Rehabilitation-Innovation/AT-HUB-Recharged/Hardware/Rev3/fa336b_9103eb10317041b39736748acd1199ef~mv2.png

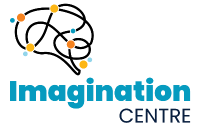
Hardware/Rev3/fa336b_9103eb10317041b39736748acd1199ef~mv2.png
