Rehabilitation-Innovation/AT-HUB-Recharged/Hardware/Rev3/images.png

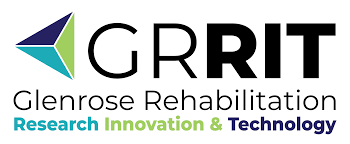
Hardware/Rev3/images.png
