Rehabilitation-Innovation/AT-HUB-Recharged/Hardware/Mechanical Assembly/Full Assembly - AT Hub/Button Cap - AT Hub V1.SLDPRT

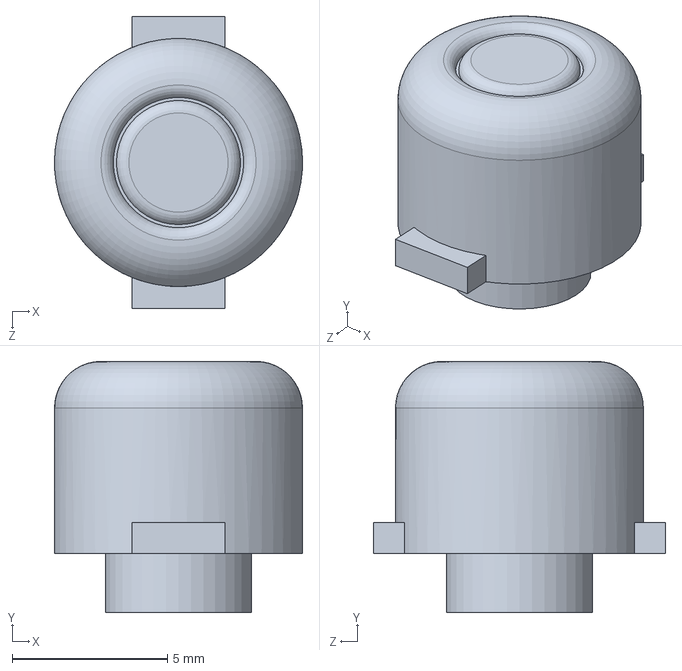
[picture p3: CAD file, 2025-08-19]
Hardware/Mechanical Assembly/Full Assembly - AT Hub/Button Cap - AT Hub V1.SLDPRT
8.00 x 8.10 x 9.42 mm
