Rehabilitation-Innovation/AT-HUB-Recharged/Hardware/Mechanical Assembly/Full Assembly - AT Hub/Switch Cap - AT Hub.SLDPRT

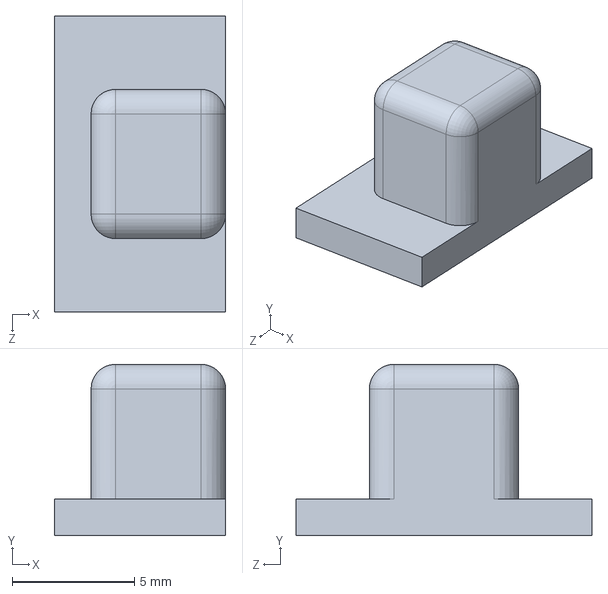
[picture p4: CAD file, 2025-08-19]
Hardware/Mechanical Assembly/Full Assembly - AT Hub/Switch Cap - AT Hub.SLDPRT
7.00 x 7.00 x 12.1 mm
