Rehabilitation-Innovation/AT-HUB-Recharged/Hardware/Rev3/3d/Same_Sky_SLW-864574-5A-RA-N-D.step

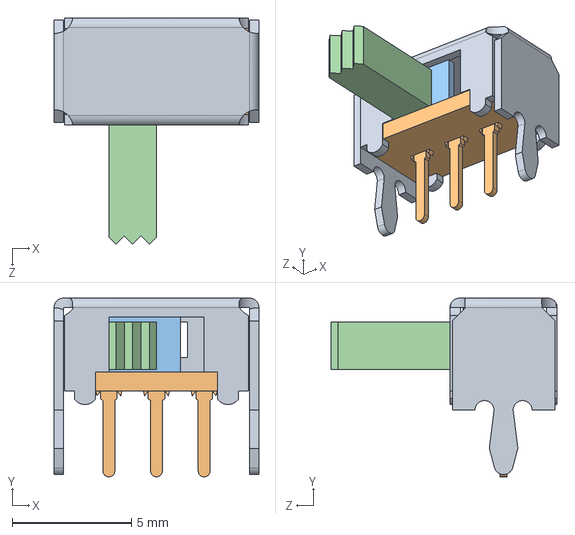
[picture p5: CAD file, 2025-06-05]
Hardware/Rev3/3d/Same_Sky_SLW-864574-5A-RA-N-D.step
8.60 x 7.50 x 9.50 mm
