Rehabilitation-Innovation/AT-HUB-Recharged/Hardware/Rev3/3d/MJ-3502.step

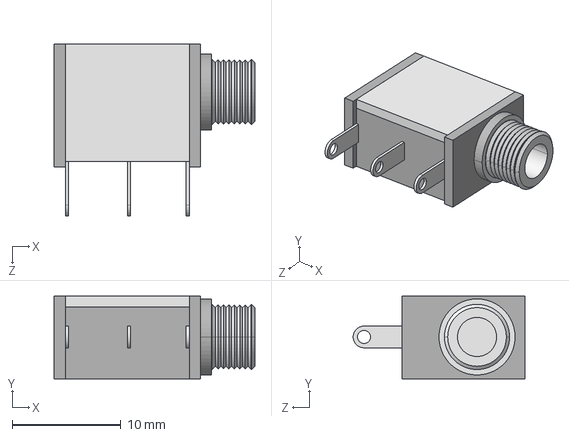
[picture p6: CAD file, 2025-06-05]
Hardware/Rev3/3d/MJ-3502.step
18.5 x 7.60 x 15.8 mm
