Rehabilitation-Innovation/AT-HUB-Recharged/Hardware/Mechanical Assembly/Full Assembly - AT Hub/Base - AT Hub.SLDPRT

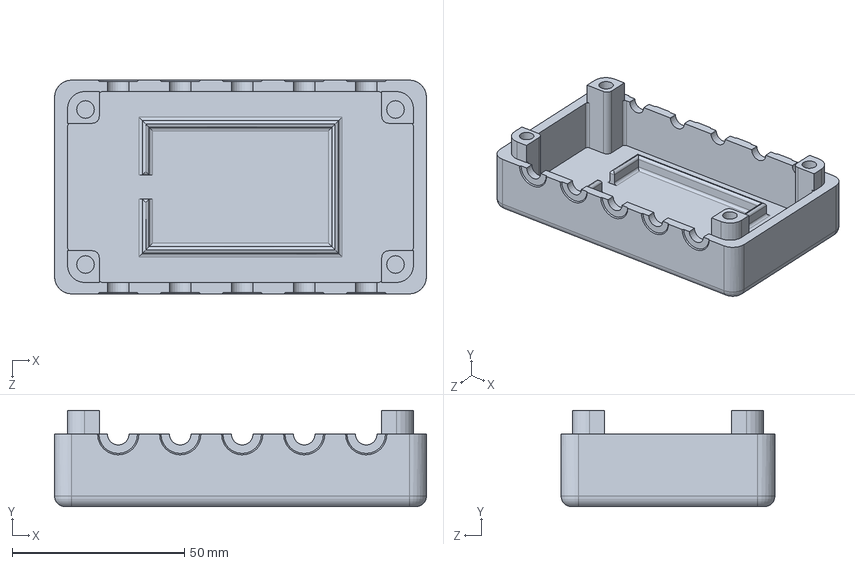
[picture p7: CAD file, 2025-08-19]
Hardware/Mechanical Assembly/Full Assembly - AT Hub/Base - AT Hub.SLDPRT
108.0 x 27.9 x 62.1 mm
