Rehabilitation-Innovation/AT-HUB-Recharged/Hardware/Rev3/3d/800AWSP9M2QE.STEP

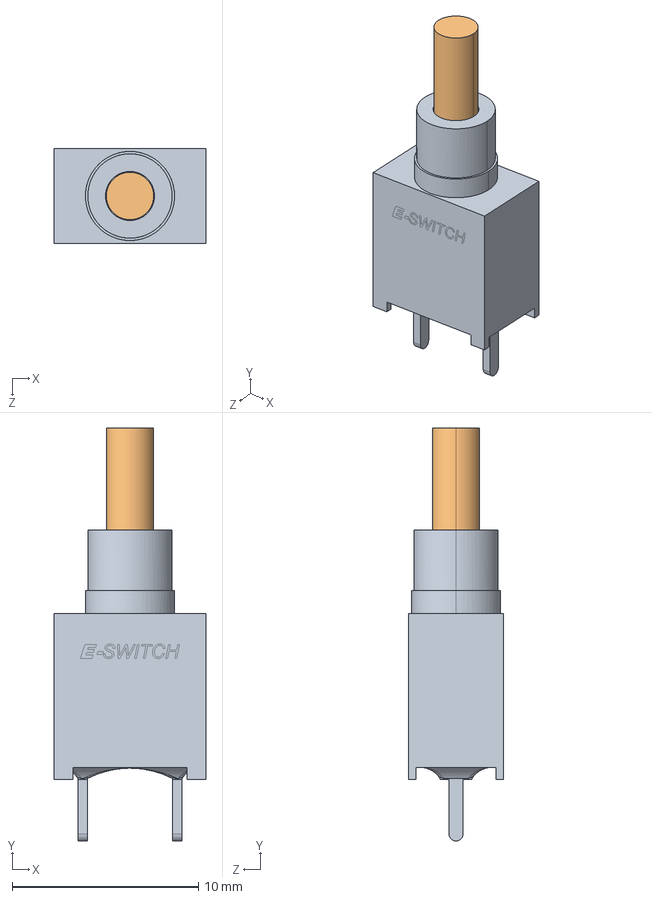
[picture p8: CAD file, 2025-06-05]
Hardware/Rev3/3d/800AWSP9M2QE.STEP
8.13 x 22.2 x 5.08 mm
