Rehabilitation-Innovation/AT-HUB-Recharged/Hardware/Mechanical Assembly/Full Assembly - AT Hub/Top - AT Hub.SLDPRT

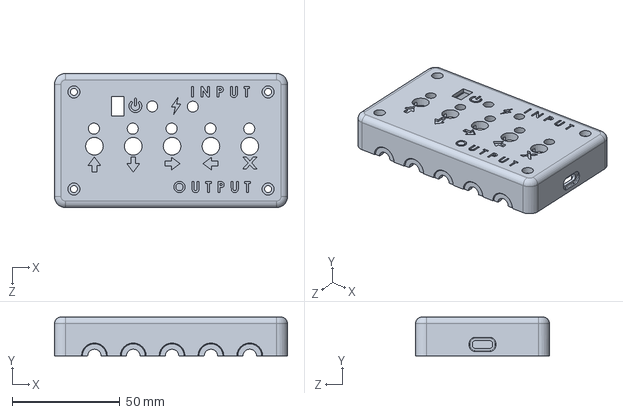
[picture p9: CAD file, 2025-08-19]
Hardware/Mechanical Assembly/Full Assembly - AT Hub/Top - AT Hub.SLDPRT
108.0 x 18.0 x 62.1 mm
