Rehabilitation-Innovation/AT-HUB-Recharged/Hardware/Rev3/3d/MIC2288YD5-TR.STEP

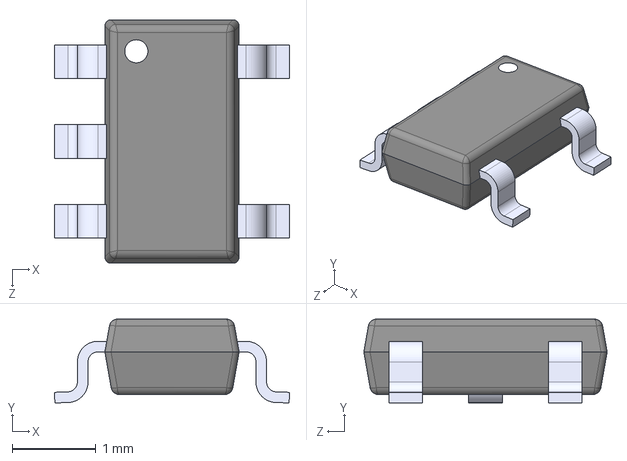
[picture p10: CAD file, 2025-06-05]
Hardware/Rev3/3d/MIC2288YD5-TR.STEP
2.80 x 1.00 x 2.90 mm
