Rehabilitation-Innovation/AT-HUB-Recharged/Hardware/Mechanical Assembly/Full Assembly - AT Hub/AT_HUB_RECHARGED 4.step

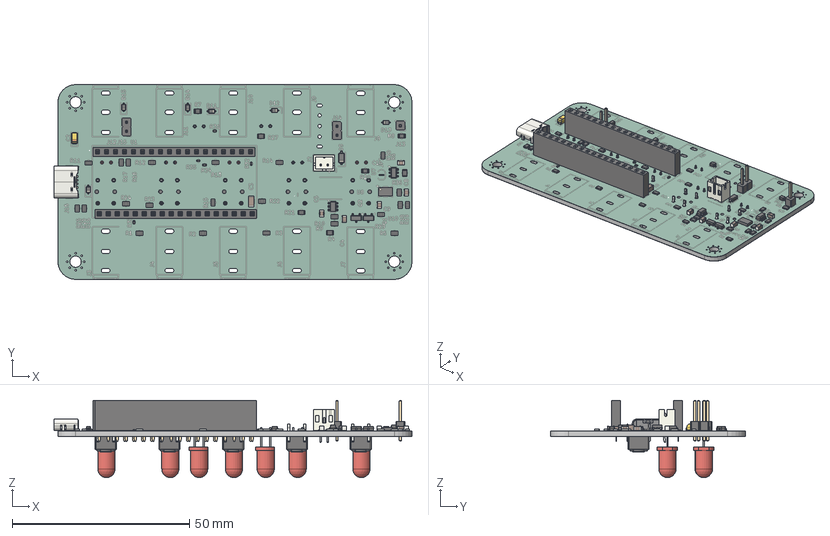
[picture p11: CAD file, 2025-07-30]
Hardware/Mechanical Assembly/Full Assembly - AT Hub/AT_HUB_RECHARGED 4.step
101.1 x 55.0 x 21.8 mm
C_0805_2012Metric x 5
PinHeader_1x02_P2.54mm_Vertical x 2
R_0805_2012Metric x 30
D_SOD-123
SOT-23-6 x 2
D_SOD-323 x 6
SOT-23 x 2
JST_PH_B2B-PH-K_1x02_P2.00mm_Vertical
R_0402_1005Metric x 5
PinHeader_1x01_P2.54mm_Vertical
PinSocket_1x18_P2.54mm_Vertical x 2
Texas_S-PDSO-N12
USB_C_Receptacle_GCT_USB4125-xx-x_6P_TopMnt_Horizontal
C_1206_3216Metric
CP_EIA-3216-18_Kemet-A
LED_D5.0mm x 7
SW_PUSH_6mm x 5
AT_HUB_RECHARGED_silkscreen
AT_HUB_RECHARGED_soldermask
AT_HUB_RECHARGED_PCB
