Rehabilitation-Innovation/AT-HUB-Recharged/Hardware/Rev3/3d/NRS6028T4R7MMGKV.STEP

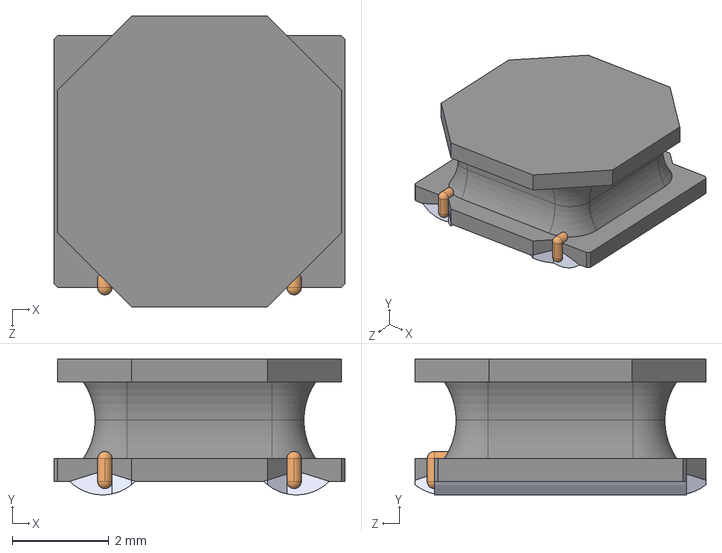
[picture p12: CAD file, 2025-06-05]
Hardware/Rev3/3d/NRS6028T4R7MMGKV.STEP
6.00 x 2.80 x 6.00 mm
