Rehabilitation-Innovation/AT-HUB-Recharged/Hardware/Rev3/3d/TLP241A_TP1_F.step

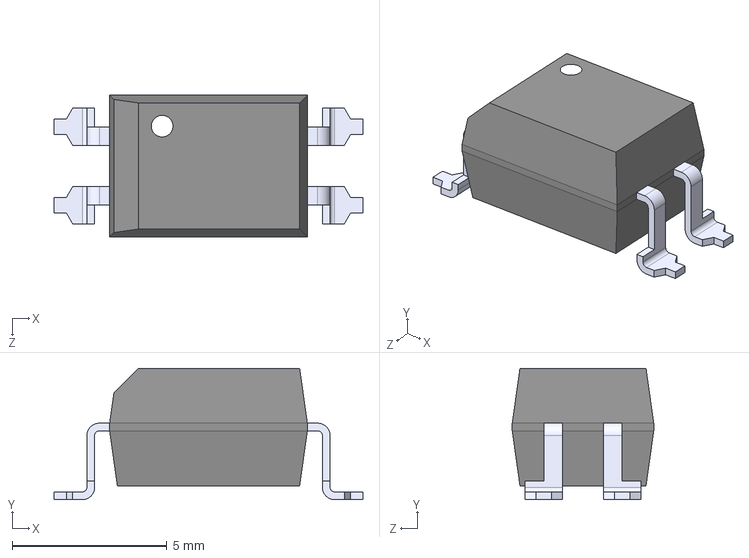
[picture p13: CAD file, 2025-03-25]
Hardware/Rev3/3d/TLP241A_TP1_F.step
10.0 x 4.25 x 4.58 mm
