Rehabilitation-Innovation/AT-HUB-Recharged/Hardware/Rev3/3d/MAX17048G_T10.step

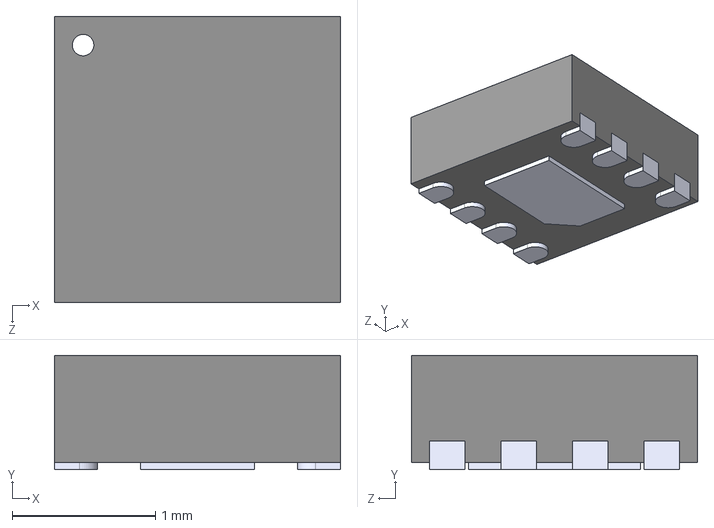
[picture p14: CAD file, 2025-06-27]
Hardware/Rev3/3d/MAX17048G_T10.step
2.00 x 0.8 x 2.00 mm
