Rehabilitation-Innovation/AT-HUB-Recharged/Hardware/Rev3/3d/BQ27427YZFR.step

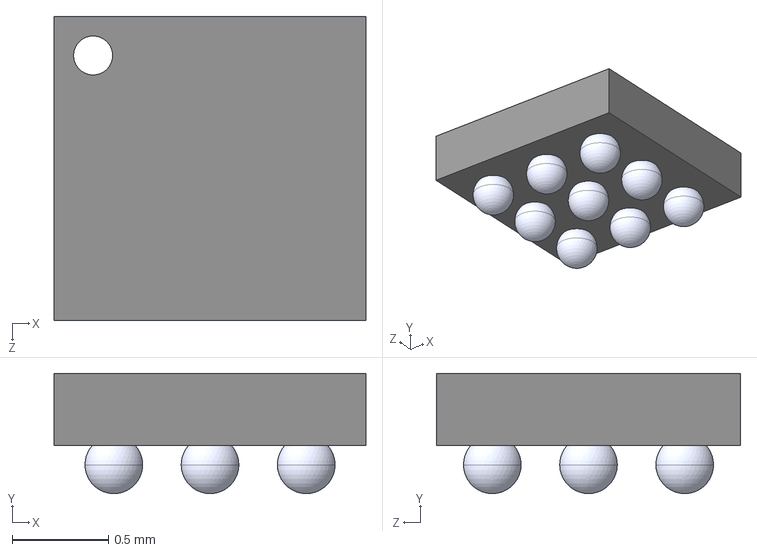
[picture p15: CAD file, 2025-06-05]
Hardware/Rev3/3d/BQ27427YZFR.step
1.62 x 0.625 x 1.58 mm
