Rehabilitation-Innovation/AT-HUB-Recharged/Hardware/Mechanical Assembly/Full Assembly - AT Hub/Full Assembly - AT Hub.SLDASM

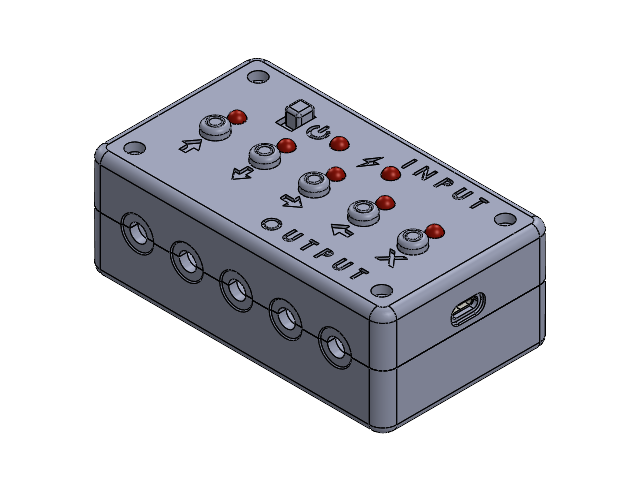
[picture p16: CAD file, 2025-08-19]
Hardware/Mechanical Assembly/Full Assembly - AT Hub/Full Assembly - AT Hub.SLDASM
Base - AT Hub
Top - AT Hub
Button Cap - AT Hub V1 x 5
C_0805_2012Metric.step x 5
PinHeader_1x02_P2.54mm_Vertical.step x 2
R_0805_2012Metric.step x 30
D_SOD-123.step
SOT-23-6.step x 2
D_SOD-323.step x 6
SOT-23.step x 2
JST_PH_B2B-PH-K_1x02_P2.00mm_Vertical.step
R_0402_1005Metric.step x 5
PinHeader_1x01_P2.54mm_Vertical.step
PinSocket_1x18_P2.54mm_Vertical.step x 2
Texas_S-PDSO-N12.step
USB_C_Receptacle_GCT_USB4125-xx-x_6P_TopMnt_Horizontal.step
C_1206_3216Metric.step
CP_EIA-3216-18_Kemet-A.step
LED_D5.0mm.step x 7
SW_PUSH_6mm.step x 5
AT_HUB_RECHARGED_silkscreen.step
AT_HUB_RECHARGED_soldermask.step
AT_HUB_RECHARGED_PCB.step
Switch Cap - AT Hub
