Rehabilitation-Innovation/AT-HUB-Recharged/(list of files, cad)

Other CAD files:
Hardware/Mechanical Assembly/Full Assembly - AT Hub/AT_HUB_RECHARGED 4.SLDASM
