Rehabilitation-Innovation/AT-HUB-Recharged/Hardware/Rev3/AT_HUB_RECHARGED/AT_HUB_RECHARGED.kicad_pcb

## KiCad design Hardware/Rev3/AT_HUB_RECHARGED/AT_HUB_RECHARGED.kicad_pcb (2025-08-11)

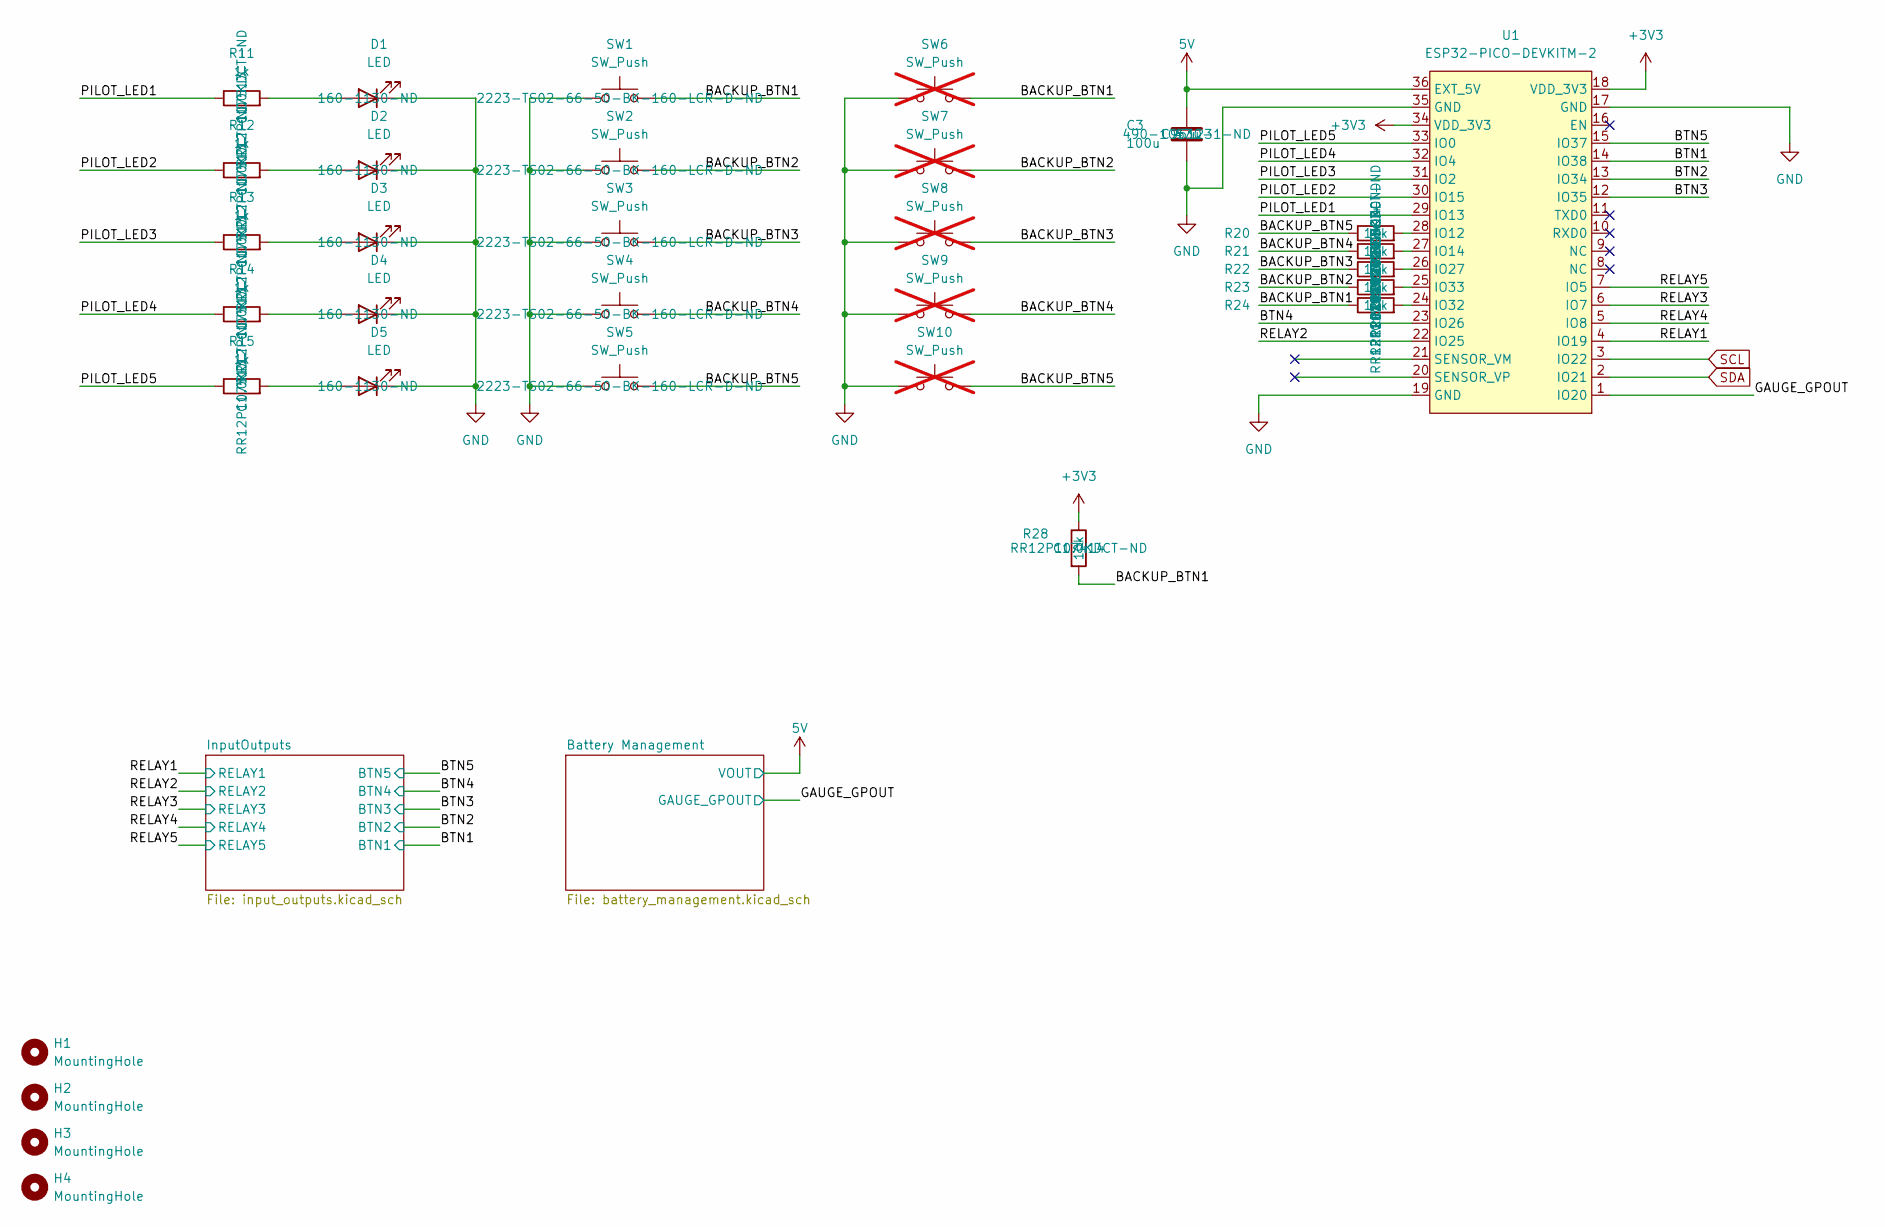
[picture p17: schematic AT_HUB_RECHARGED.kicad_sch, AT-HUB-Recharged]

Parts:
C3: 100u; C_1206_3216Metric; LCSC C96123
D1, D2, D3, D4, D5: LED; LED_D5.0mm
H1, H2, H3, H4: MountingHole; MountingHole_3.2mm_M3_Pad_Via
R11, R12, R13, R14, R15: 1k; R_0805_2012Metric; LCSC C17513
R20, R21, R22, R23, R24, R28: 10k; R_0805_2012Metric; LCSC C17414
SW1, SW2, SW3, SW4, SW5: SW_Push; SW_PUSH_6mm
SW6, SW7, SW8, SW9, SW10: SW_Push; SW_800AWSP9M2QE; not fitted
U1: ESP32-PICO-DEVKITM-2; XCVR_ESP32-PICO-KIT-V4.1

Connections:
5V: C3.1, U1.36 (EXT_5V); also elsewhere on the board
+3V3: R28.1, U1.18 (VDD_3V3), U1.34 (VDD_3V3); also elsewhere on the board
/BACKUP_BTN1: R24.1, R28.2, SW1.2, SW6.2
/BACKUP_BTN2: R23.1, SW2.2, SW7.2
/BACKUP_BTN3: R22.1, SW3.2, SW8.2
/BACKUP_BTN4: R21.1, SW4.2, SW9.2
/BACKUP_BTN5: R20.1, SW5.2, SW10.2
/BTN1: U1.14 (IO38); also elsewhere on the board
/BTN2: U1.13 (IO34); also elsewhere on the board
/BTN3: U1.12 (IO35); also elsewhere on the board
/BTN4: U1.23 (IO26); also elsewhere on the board
/BTN5: U1.15 (IO37); also elsewhere on the board
/GAUGE_GPOUT: U1.1 (IO20); also elsewhere on the board
/PILOT_LED1: R11.1, U1.29 (IO13)
/PILOT_LED2: R12.1, U1.30 (IO15)
/PILOT_LED3: R13.1, U1.31 (IO2)
/PILOT_LED4: R14.1, U1.32 (IO4)
/PILOT_LED5: R15.1, U1.33 (IO0)
/RELAY1: U1.4 (IO19); also elsewhere on the board
/RELAY2: U1.22 (IO25); also elsewhere on the board
/RELAY3: U1.6 (IO7); also elsewhere on the board
/RELAY4: U1.5 (IO8); also elsewhere on the board
/RELAY5: U1.7 (IO5); also elsewhere on the board
GND: C3.2, D1.1 (K), D2.1 (K), D3.1 (K), D4.1 (K), D5.1 (K), SW1.1, SW2.1, SW3.1, SW4.1, SW5.1, SW6.1, SW7.1, SW8.1, SW9.1, SW10.1, U1.17 (GND), U1.19 (GND), U1.35 (GND); also elsewhere on the board
unnamed: D1.2 (A), R11.2
unnamed: D2.2 (A), R12.2
unnamed: D3.2 (A), R13.2
unnamed: D4.2 (A), R14.2
unnamed: D5.2 (A), R15.2
unnamed: R20.2, U1.28 (IO12)
unnamed: R21.2, U1.27 (IO14)
unnamed: R22.2, U1.26 (IO27)
unnamed: R24.2, U1.24 (IO32)
unnamed: R23.2, U1.25 (IO33)
SCL: U1.3 (IO22); also elsewhere on the board
SDA: U1.2 (IO21); also elsewhere on the board

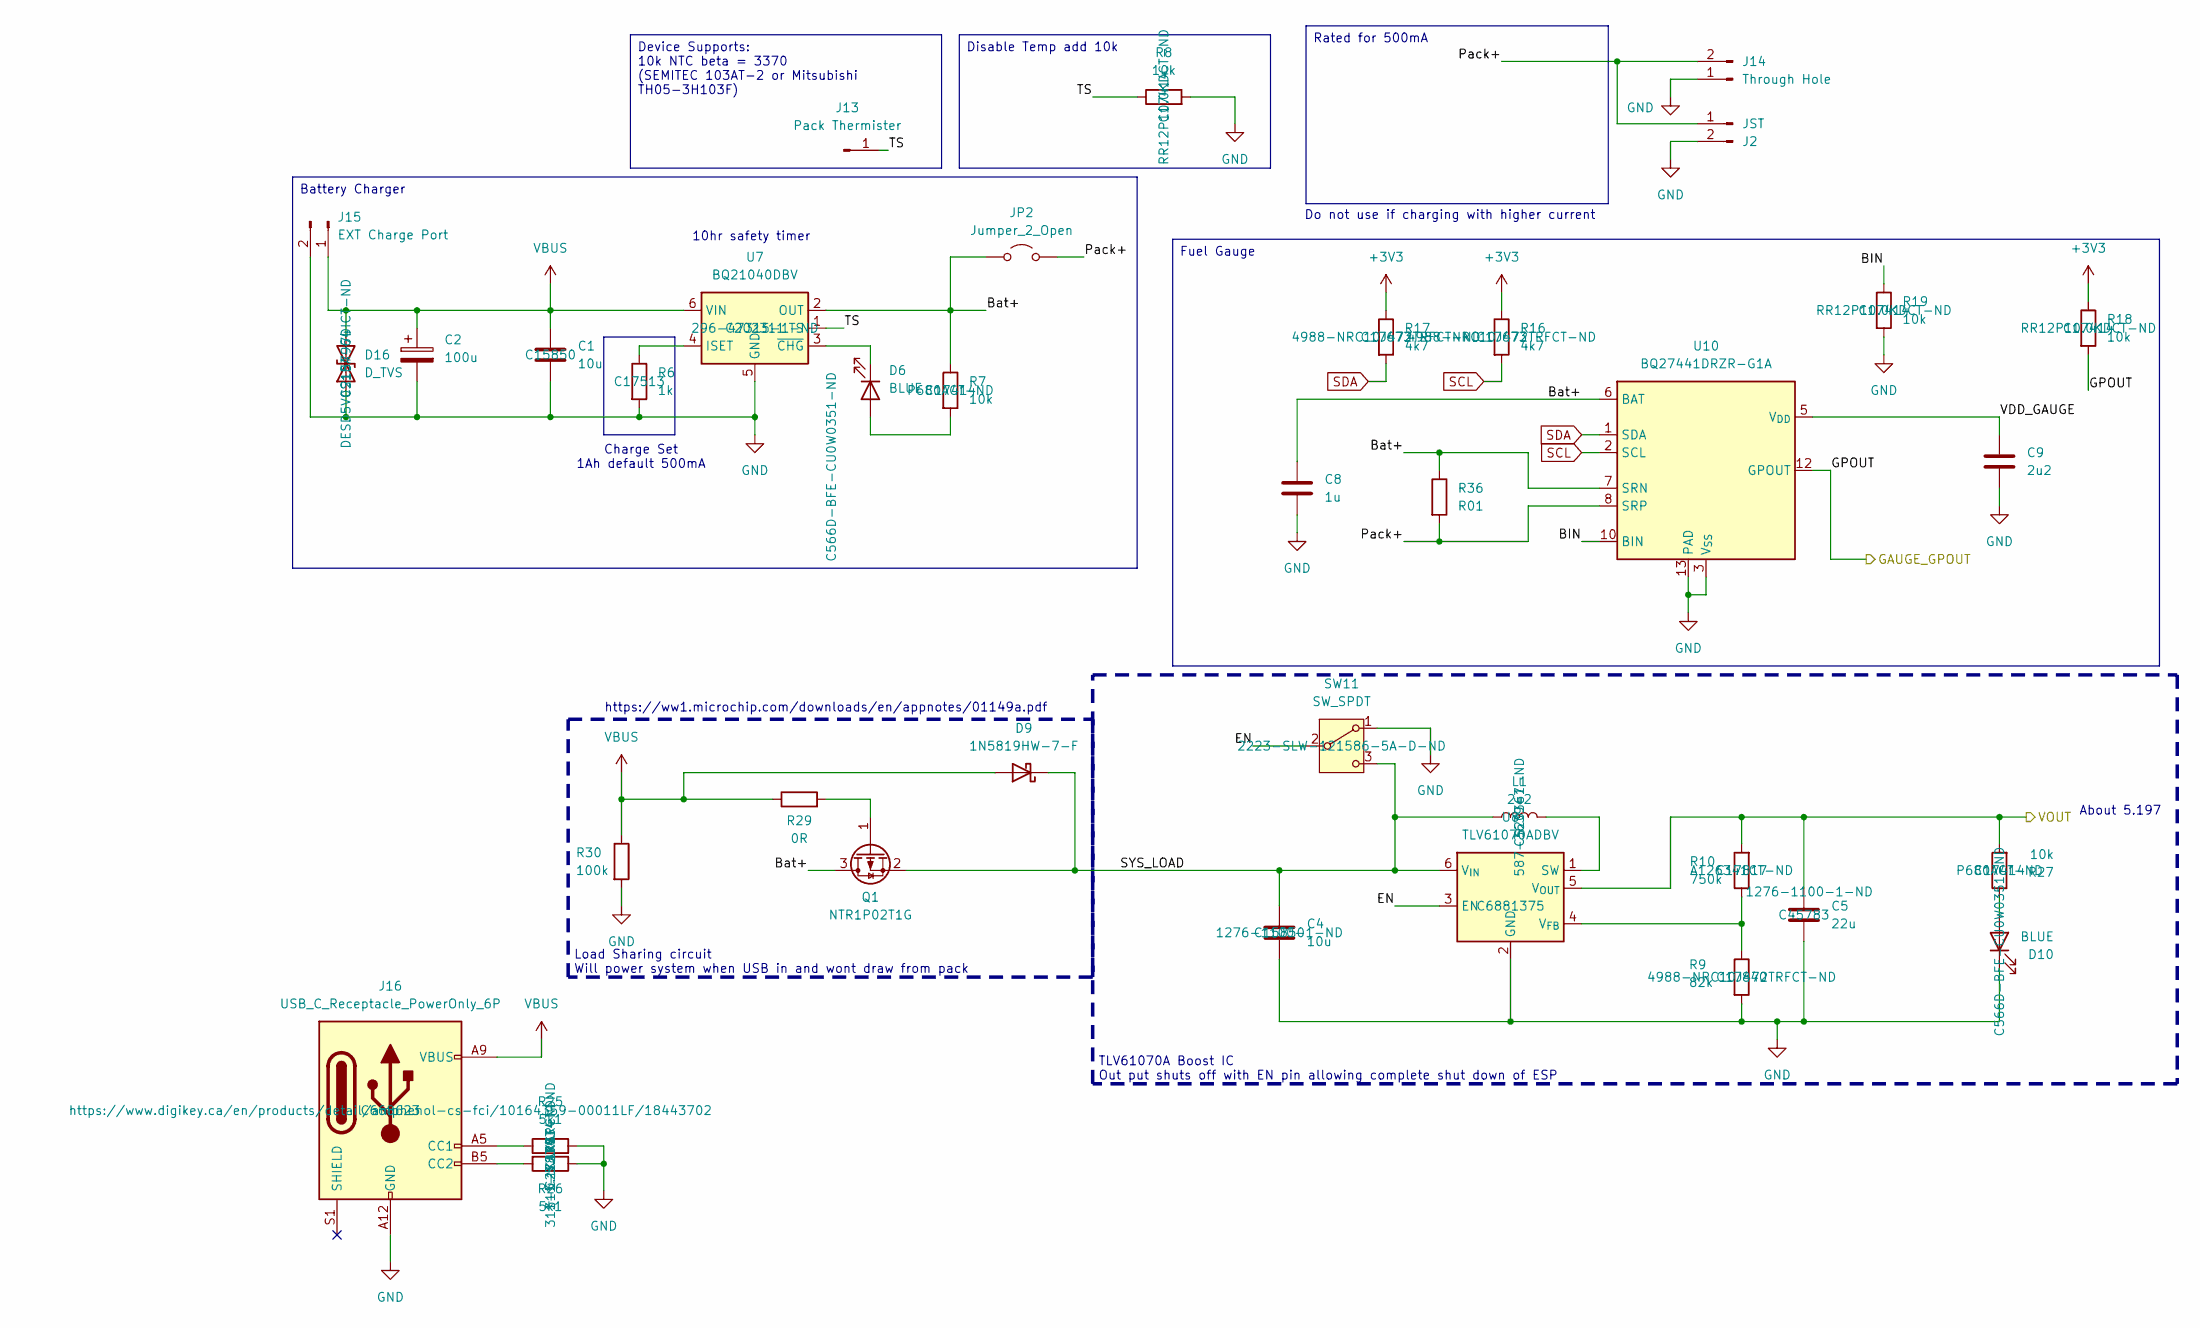
[picture p18: schematic battery_management.kicad_sch, AT-HUB-Recharged]

Parts:
C1, C4: 10u; C_0805_2012Metric; LCSC C15850
C2: 100u; CP_EIA-3216-18_Kemet-A
C5: 22u; C_0805_2012Metric; LCSC C45783
C8: 1u; C_0805_2012Metric; LCSC C377773
C9: 2u2; C_0805_2012Metric; LCSC C377773
D6, D10: BLUE; LED_D5.0mm
D9: 1N5819HW-7-F; D_SOD-123; LCSC C82544
D16: D_TVS; D_SOD-323_HandSoldering; LCSC C2157964
J2: JST; JST_PH_B2B-PH-K_1x02_P2.00mm_Vertical
J13: Pack Thermister; PinHeader_1x01_P2.54mm_Vertical
J14: Through Hole; PinHeader_1x02_P2.54mm_Vertical
J15: EXT Charge Port; PinHeader_1x02_P2.54mm_Vertical
J16: USB_C_Receptacle_PowerOnly_6P; USB_C_Receptacle_HRO_TYPE-C-31-M-17; LCSC C668623
JP2: Jumper_2_Open; SolderJumper-2_P1.3mm_Open_RoundedPad1.0x1.5mm
L1: 2u2; Ceaiya SMD,6x6mm CR6028-2R2N; LCSC C520367
Q1: NTR1P02T1G; SOT-23; LCSC C129192
R6: 1k; R_0805_2012Metric; LCSC C17513
R7, R8, R18, R19, R27: 10k; R_0805_2012Metric; LCSC C17414
R9: 82k; R_0805_2012Metric; LCSC C17840
R10: 750k; R_0805_2012Metric; LCSC C17817
R16, R17: 4k7; R_0805_2012Metric; LCSC C17673
R25, R26: 5k1; R_0805_2012Metric; LCSC C27834
R29: 0R; R_0805_2012Metric; LCSC C17477
R30: 100k; R_0805_2012Metric; LCSC C149504
R36: R01; R_0805_2012Metric; LCSC C163089
SW11: SW_SPDT; SW_SLW-121586-5A-D
U7: BQ21040DBV; SOT-23-6; LCSC C202311
U8: TLV61070ADBV; SOT-23-6; LCSC C6881375
U10: BQ27441DRZR-G1A; Texas_S-PDSO-N12; LCSC C473397

Connections:
5V: C5.1, R10.2, R27.2, U8.5 (V_{OUT}); also elsewhere on the board
+3V3: R16.1, R17.1, R18.1; also elsewhere on the board
/Battery Management/BIN: R19.1, U10.10 (BIN)
/Battery Management/Bat+: C8.1, JP2.1 (A), Q1.3 (D), R7.1, R36.1, U7.2 (OUT), U10.6 (BAT), U10.7 (SRN)
/Battery Management/EN: SW11.2 (B), U8.3 (EN)
/Battery Management/Pack+: J2.1, J14.2, JP2.2 (B), R36.2, U10.8 (SRP)
/Battery Management/SYS_LOAD: C4.1, D9.1 (K), L1.1, Q1.2 (S), SW11.3 (C), U8.6 (V_{IN})
/Battery Management/TS: J13.1, R8.1, U7.1 (TS)
/Battery Management/VDD_GAUGE: C9.1, U10.5 (V_{DD})
/GAUGE_GPOUT: R18.2, U10.12 (GPOUT); also elsewhere on the board
GND: C1.2, C2.2, C4.2, C5.2, C8.2, C9.2, D10.1 (K), D16.1 (A1), J2.2, J14.1, J15.2, J16.A12 (GND), J16.B12 (GND), R6.2, R8.2, R9.2, R19.2, R25.2, R26.1, R30.2, SW11.1 (A), U7.5 (GND), U8.2 (GND), U10.3 (V_{SS}), U10.13 (PAD); also elsewhere on the board
unnamed: D6.2 (A), R7.2
unnamed: D6.1 (K), U7.3 (~CHG)
unnamed: D10.2 (A), R27.1
unnamed: J16.A5 (CC1), R25.1
unnamed: J16.B5 (CC2), R26.2
unnamed: Q1.1 (G), R29.2
unnamed: R6.1, U7.4 (ISET)
unnamed: L1.2, U8.1 (SW)
unnamed: R9.1, R10.1, U8.4 (V_{FB})
SCL: R16.2, U10.2 (SCL); also elsewhere on the board
SDA: R17.2, U10.1 (SDA); also elsewhere on the board
VBUS: C1.1, C2.1, D9.2 (A), D16.2 (A2), J15.1, J16.A9 (VBUS), J16.B9 (VBUS), R29.1, R30.1, U7.6 (VIN)

Notes on the sheet:
Load Sharing circuit Will power system when USB in and wont draw from pack
10hr safety timer
About 5.197
Do not use if charging with higher current
TLV61070A Boost IC Out put shuts off with EN pin allowing complete shut down of ESP
https://ww1.microchip.com/downloads/en/appnotes/01149a.pdf
Charge Set 1Ah default 500mA
Fuel Gauge
Device Supports: 10k NTC beta = 3370 (SEMITEC 103AT-2 or Mitsubishi TH05-3H103F)
Disable Temp add 10k
Battery Charger
Rated for 500mA

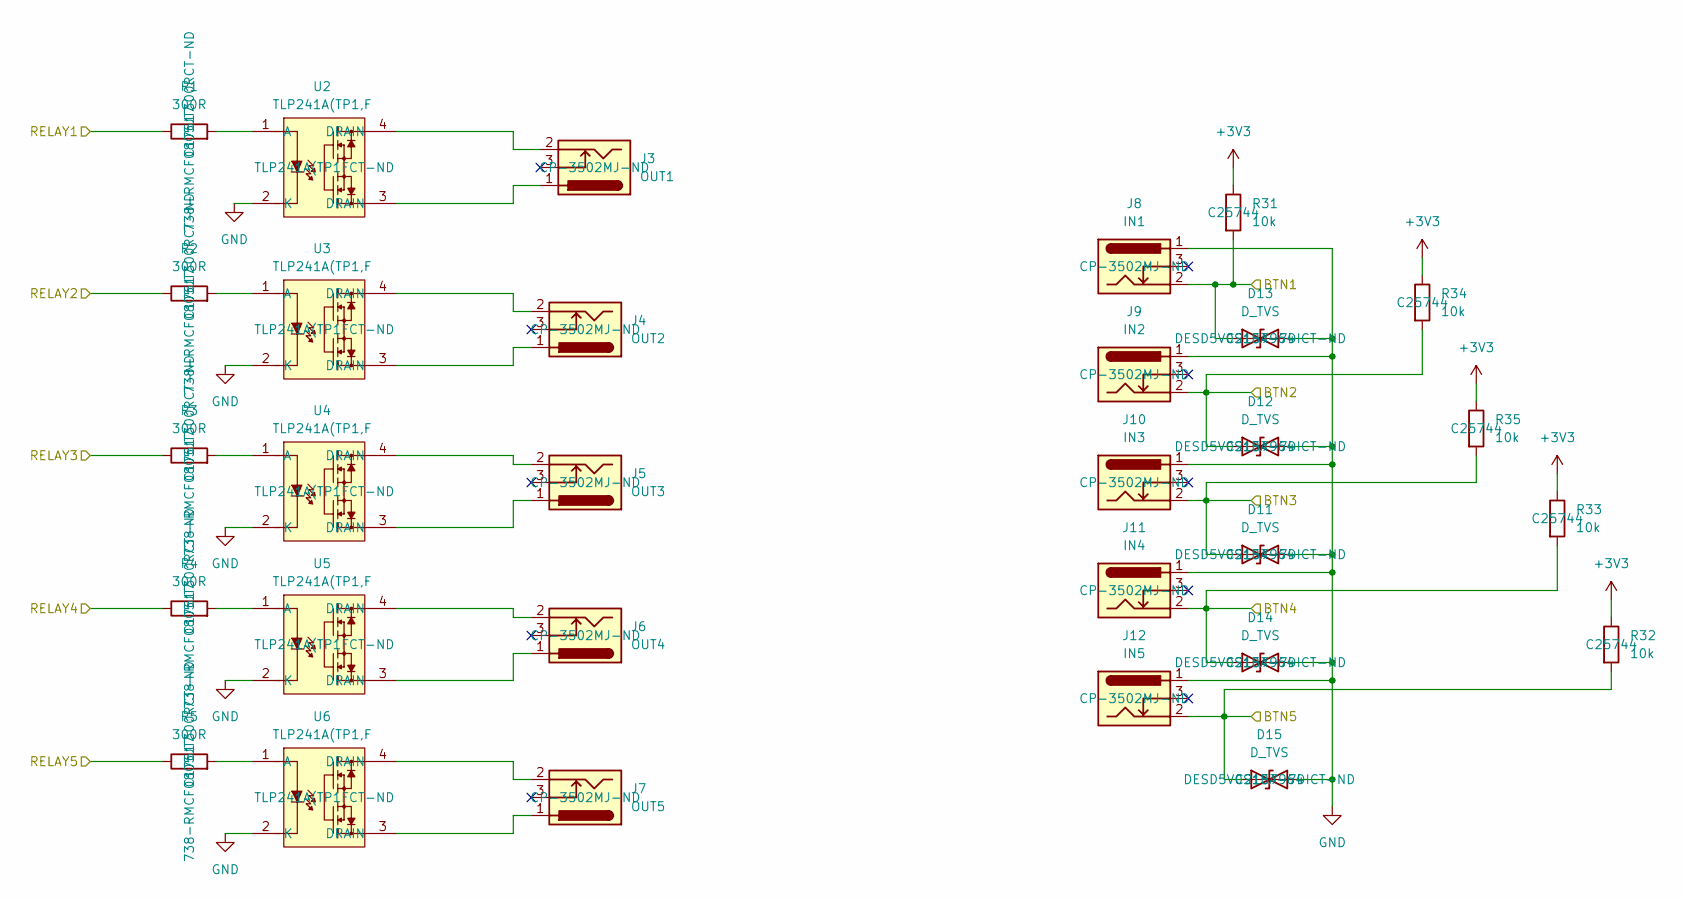
[picture p19: schematic input_outputs.kicad_sch, AT-HUB-Recharged]

Parts:
D11, D12, D13, D14, D15: D_TVS; D_SOD-323_HandSoldering; LCSC C2157964
J3: OUT1; CUI_MJ-3502
J4: OUT2; CUI_MJ-3502
J5: OUT3; CUI_MJ-3502
J6: OUT4; CUI_MJ-3502
J7: OUT5; CUI_MJ-3502
J8: IN1; CUI_MJ-3502
J9: IN2; CUI_MJ-3502
J10: IN3; CUI_MJ-3502
J11: IN4; CUI_MJ-3502
J12: IN5; CUI_MJ-3502
R1, R2, R3, R4, R5: 300R; R_0805_2012Metric; LCSC C17617
R31, R32, R33, R34, R35: 10k; R_0402_1005Metric; LCSC C25744
U2, U3, U4, U5, U6: TLP241A(TP1,F; 11-5B201S_TOS

Connections:
+3V3: R31.1, R32.1, R33.1, R34.1, R35.1; also elsewhere on the board
/BTN1: D13.1 (A1), J8.2, R31.2; also elsewhere on the board
/BTN2: D12.1 (A1), J9.2, R34.2; also elsewhere on the board
/BTN3: D11.1 (A1), J10.2, R35.2; also elsewhere on the board
/BTN4: D14.1 (A1), J11.2, R33.2; also elsewhere on the board
/BTN5: D15.1 (A1), J12.2, R32.2; also elsewhere on the board
/RELAY1: R1.1; also elsewhere on the board
/RELAY2: R2.1; also elsewhere on the board
/RELAY3: R3.1; also elsewhere on the board
/RELAY4: R4.1; also elsewhere on the board
/RELAY5: R5.1; also elsewhere on the board
GND: D11.2 (A2), D12.2 (A2), D13.2 (A2), D14.2 (A2), D15.2 (A2), J8.1, J9.1, J10.1, J11.1, J12.1, U2.2 (K), U3.2 (K), U4.2 (K), U5.2 (K), U6.2 (K); also elsewhere on the board
unnamed: J3.1, U2.3 (DRAIN)
unnamed: J3.2, U2.4 (DRAIN)
unnamed: J4.1, U3.3 (DRAIN)
unnamed: J4.2, U3.4 (DRAIN)
unnamed: J5.1, U4.3 (DRAIN)
unnamed: J5.2, U4.4 (DRAIN)
unnamed: J6.1, U5.3 (DRAIN)
unnamed: J6.2, U5.4 (DRAIN)
unnamed: J7.1, U6.3 (DRAIN)
unnamed: J7.2, U6.4 (DRAIN)
unnamed: R1.2, U2.1 (A)
unnamed: R2.2, U3.1 (A)
unnamed: R3.2, U4.1 (A)
unnamed: R4.2, U5.1 (A)
unnamed: R5.2, U6.1 (A)

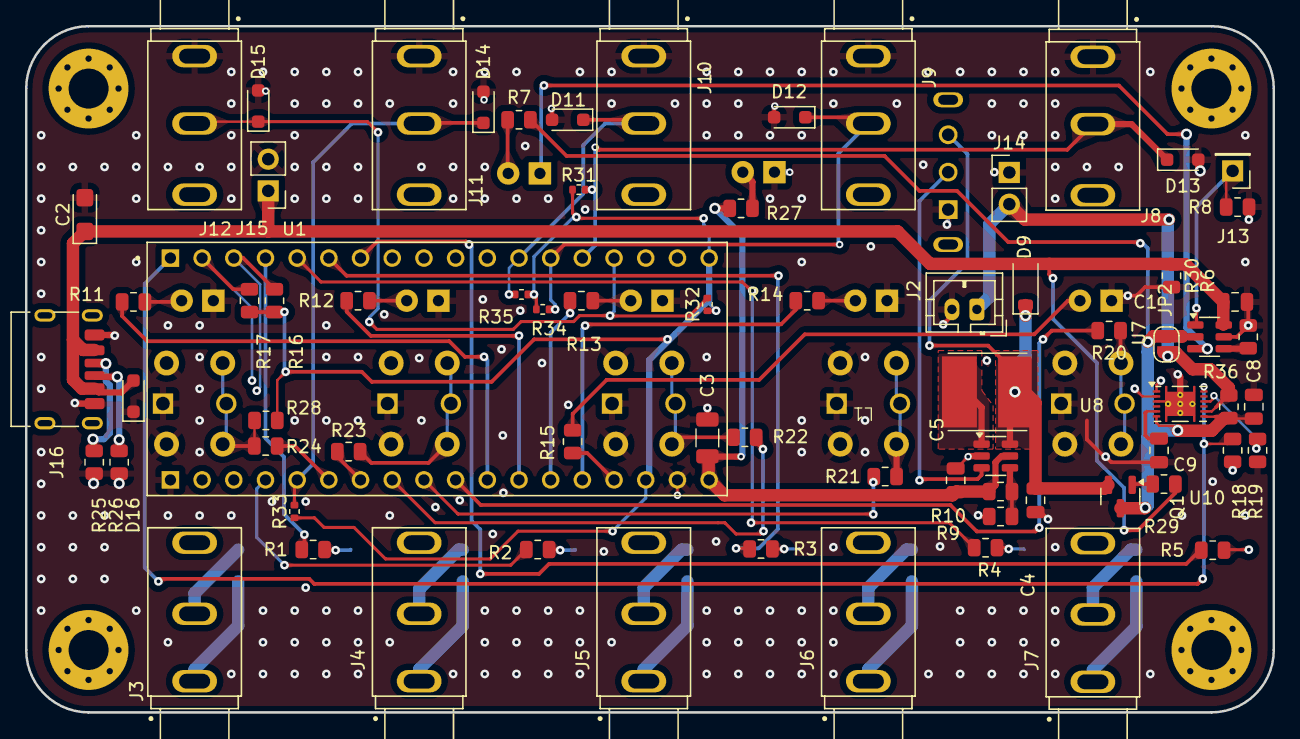
[picture p20: board AT_HUB_RECHARGED.kicad_pcb from above]

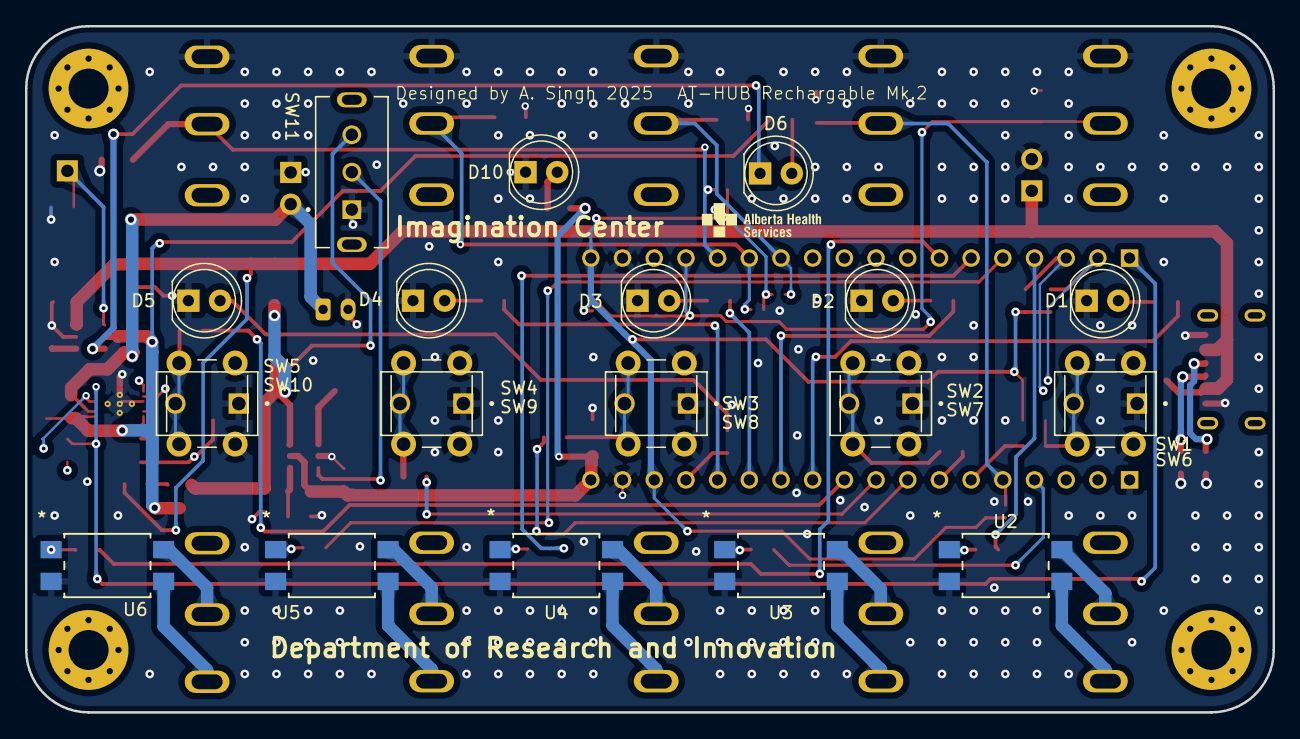
[picture p21: board AT_HUB_RECHARGED.kicad_pcb from below]

Board: 4 copper layers, 100.0 x 55.0 mm, 99 parts (23 on the bottom side), 68 nets.
