Rehabilitation-Innovation/AT-HUB-Recharged/(commit log)

2025-06-05 Added new Boost started new layout verification and cpos
    [800AWSP9M2QE.STEP, AT_HUB_RECHARGED.csv, AT_HUB_RECHARGED.kicad_pcb, AT_HUB_RECHARGED.kicad_sch, BQ27427YZFR.step, MIC2288YD5-TR.STEP, MJ-3502.step, NRS6028T4R7MMGKV.STEP]
2025-06-13 Added new protections and load sharing for lipo, also changed inductor to be autoplaced
    [AT_HUB_RECHARGED.kicad_pcb, AT_HUB_RECHARGED.kicad_sch, battery_management.kicad_sch, bom.csv, designators.csv, input_outputs.kicad_sch, positions.csv]
2025-06-16 Changed net label for charging subcircuit to Bat+
    [battery_management.kicad_sch]
2025-06-27 Done the design will verify
    [AT_HUB_RECHARGED.kicad_pcb, AT_HUB_RECHARGED.kicad_sch, MAX17048G_T10.step, battery_management.kicad_sch, input_outputs.kicad_sch]
2025-07-30 Added Rev 3
    [800AWSP9M2QE.STEP, AT_HUB_RECHARGED.csv, AT_HUB_RECHARGED.kicad_pcb, AT_HUB_RECHARGED.kicad_sch, AT_HUB_RECHARGED.step, BQ27427YZFR.step, MAX17048G_T10.step, MIC2288YD5-TR.STEP]
2025-08-11 Final working
    [AT_HUB_RECHARGED.kicad_pcb, AT_HUB_RECHARGED.kicad_sch, battery_management.kicad_sch]
